x-labz/UV-badge/README.md

# UV-badge

Project site on hackaday.io https://hackaday.io/project/4706-uv-badge 

Twitter: @xLabzNet
