x-labz/UV-badge/design/prog-adapter/prog-adapter.FCStd

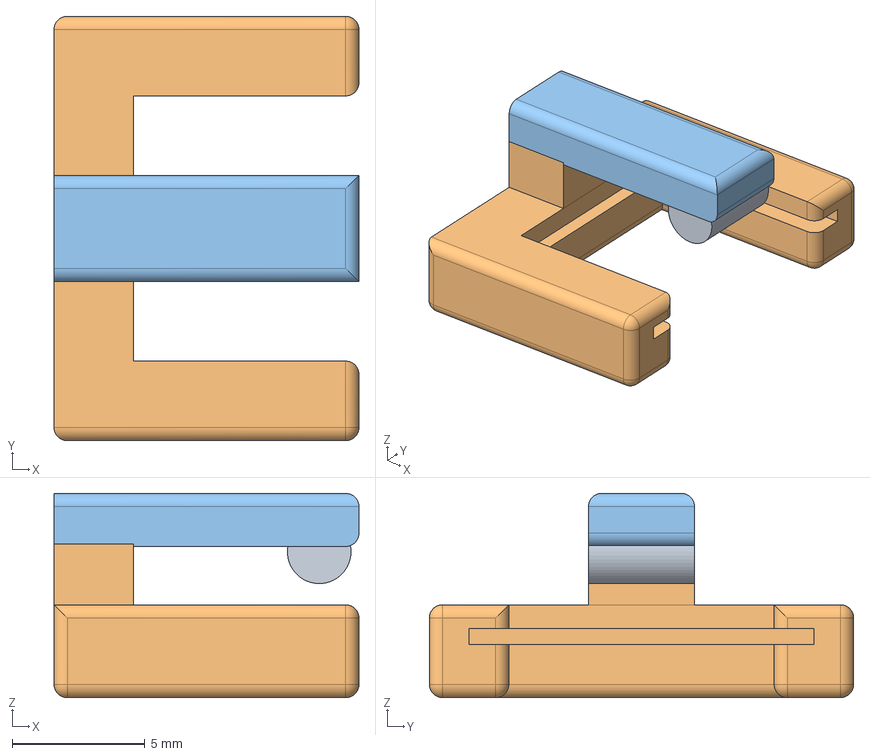
[picture p7: CAD file, 2015-08-31]
design/prog-adapter/prog-adapter.FCStd
11.5 x 16.0 x 7.70 mm
