x-labz/UV-badge/design/UV-case-2.1.4-exp.FCStd

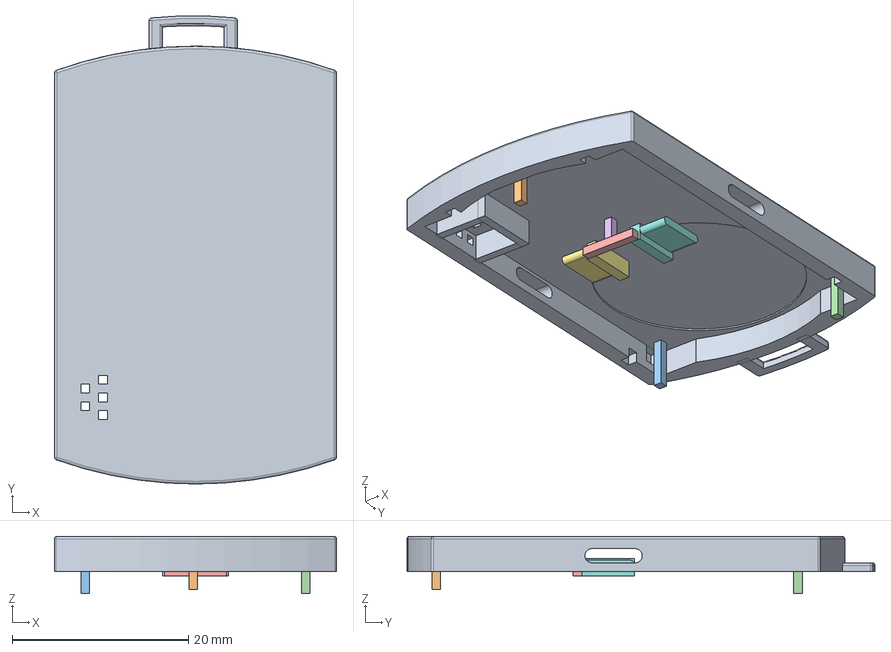
[picture p8: CAD file, 2015-07-29]
design/UV-case-2.1.4-exp.FCStd
32.0 x 53.1 x 6.50 mm
Fusion-btn-1
Fusion-btn-2
