x-labz/UV-badge/(list of files, cad)

Other CAD files:
design/UV-case-2.1.4-exp.stl
design/prog-adapter/prog-adapter.stl
