x-labz/UV-badge/(threads)

Thread 1 (2016-06-06):

BOM

loldavid6, 2016-06-06:
The BOM reports that it is formatted wrong, just letting you know.
