x-labz/UV-badge/hardware/uvi-2.1.brd

## EAGLE design hardware/uvi-2.1.brd (2015-07-29)

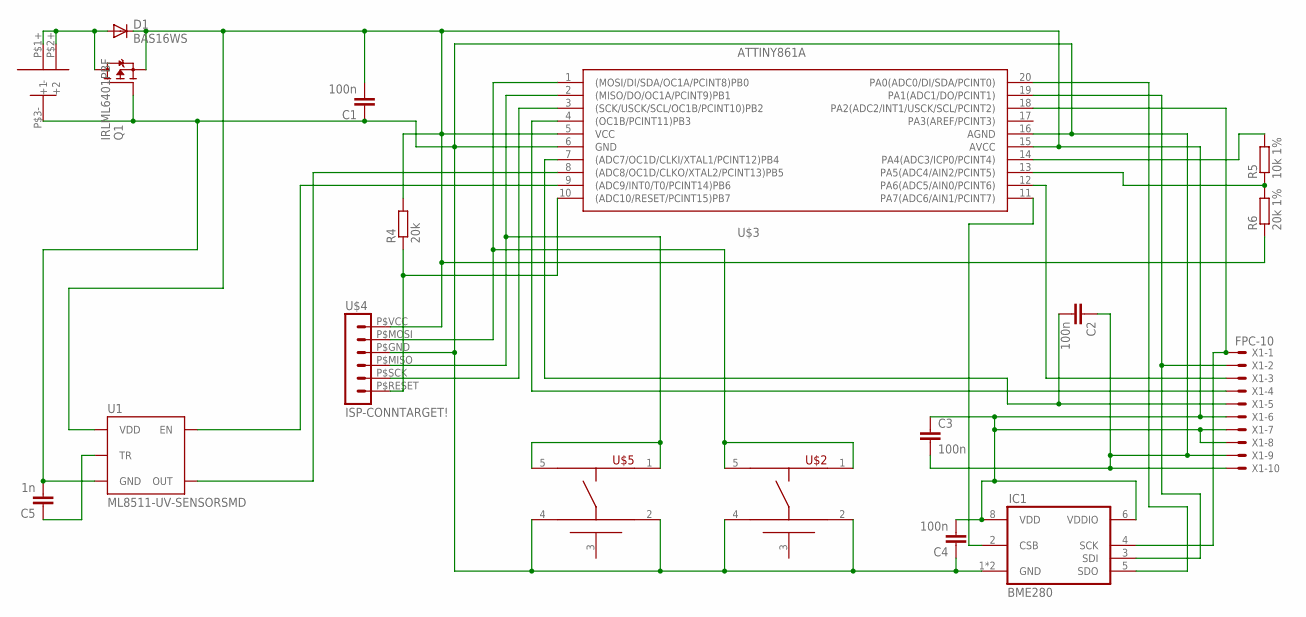
[picture p9: schematic uvi-2.1.sch]

Parts:
C1, C2, C3, C4: 100n; C0805
C5: 1n; C0805
D1: BAS16WS; SOD323-W
IC1: BME280; BMP280
Q1: IRLML6401PBF; SOT23
R4: 20k; R0805
R5: 10k 1%; R0805
R6: 20k 1%; R0805
U1: ML8511-UV-SENSORSMD; ML8511
U$1: CR2016; BAT-HLD-002
U$2, U$5: KMSXXXG; C&K-KMS-SWITCH
U$3: ATTINY861A; TSSOP20
U$4: ISP-CONNTARGET!; ISP-TARGET
X1: FPC-10; FPC-10-BTM

Connections:
GND: C1.1, C2.1, C3.2, C4.1, C5.2, IC1.1 (GND), IC1.7 (GND), Q1.1 (G), U1.5 (GND), U$1.P$3- (-), U$2.2, U$2.4, U$3.6 (GND), U$3.16 (AGND), U$4.P$GND (GND), U$5.2, U$5.4, X1.P$9, X1.P$10
unnamed: D1.A, Q1.3 (D), U$1.P$1+ (+1), U$1.P$2+ (+2)
unnamed: R4.1, U$3.10 ((ADC10/RESET/PCINT15)PB7), U$4.P$RESET (RESET)
unnamed: IC1.5 (SDO), U$3.20 (PA0(ADC0/DI/SDA/PCINT0))
unnamed: R5.2, U$3.14 (PA4(ADC3/ICP0/PCINT4))
unnamed: IC1.4 (SCK), U$3.18 (PA2(ADC2/INT1/USCK/SCL/PCINT2)), X1.P$1
unnamed: C5.1, U1.10 (TR)
unnamed: IC1.3 (SDI), U$3.19 (PA1(ADC1/DO/PCINT1)), X1.P$2
unnamed: U1.8 (OUT), U$3.8 ((ADC8/OC1D/CLKO/XTAL2/PCINT13)PB5)
unnamed: C2.2, U$3.7 ((ADC7/OC1D/CLKI/XTAL1/PCINT12)PB4), X1.P$5
unnamed: U$3.2 ((MISO/DO/OC1A/PCINT9)PB1), U$4.P$MISO (MISO), U$5.1, U$5.5
unnamed: U$3.3 ((SCK/USCK/SCL/OC1B/PCINT10)PB2), U$4.P$SCK (SCK)
unnamed: IC1.2 (CSB), U$3.11 (PA7(ADC6/AIN1/PCINT7))
unnamed: U$3.4 ((OC1B/PCINT11)PB3), X1.P$4
unnamed: U$3.12 (PA6(ADC5/AIN0/PCINT6)), X1.P$3
unnamed: U$2.1, U$2.5, U$3.1 ((MOSI/DI/SDA/OC1A/PCINT8)PB0), U$4.P$MOSI (MOSI)
unnamed: U1.4 (EN), U$3.9 ((ADC9/INT0/T0/PCINT14)PB6)
unnamed: R5.1, R6.2, U$3.13 (PA5(ADC4/AIN2/PCINT5))
VCC: C1.2, C3.1, C4.2, D1.C, IC1.6 (VDDIO), IC1.8 (VDD), Q1.2 (S), R4.2, R6.1, U1.7 (VDD), U$3.5 (VCC), U$3.15 (AVCC), U$4.P$VCC (VCC), X1.P$6, X1.P$7, X1.P$8

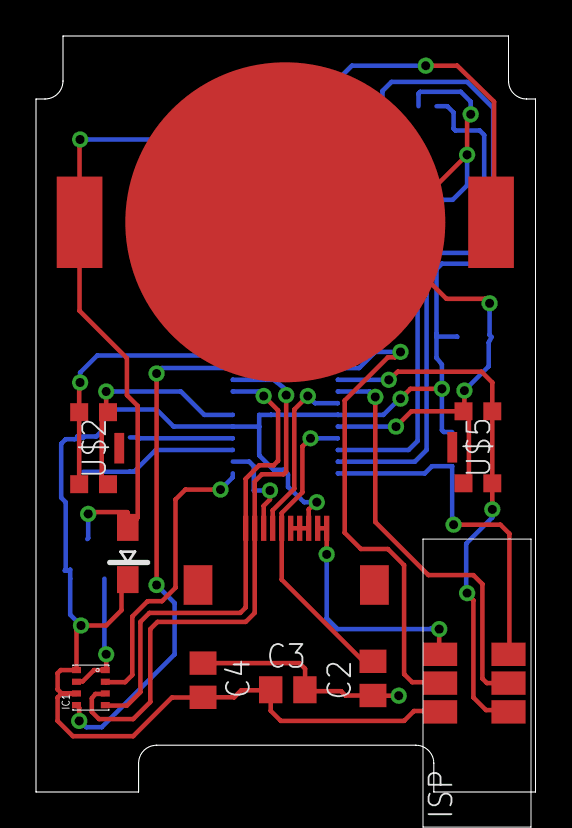
[picture p10: board uvi-2.1.brd from above]

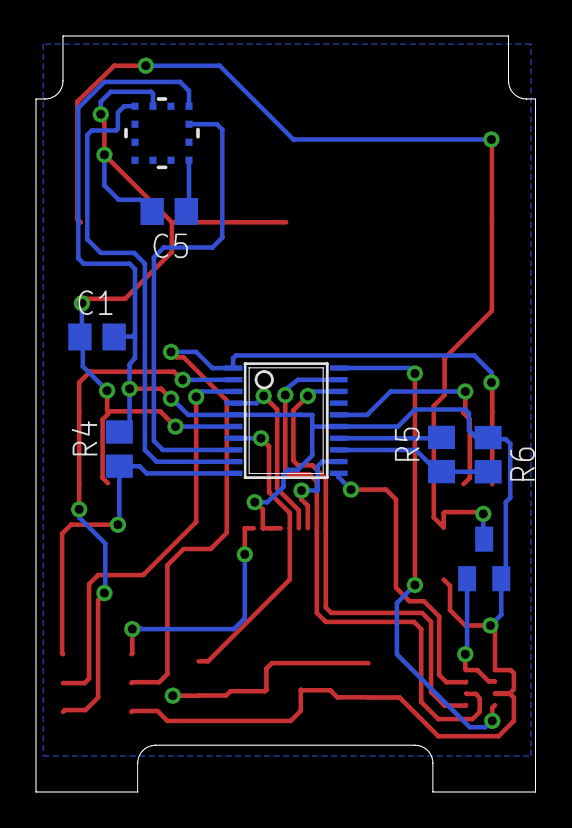
[picture p11: board uvi-2.1.brd from below]

Board: 2 copper layers, 27.8 x 42.0 mm, 18 parts (8 on the bottom side), 19 nets.
