x-labz/UV-badge/firmware/v4.0/set_speed.h

#define SP_8_MHz  1
#define SP_4_MHz  2
#define SP_2_MHz  3
#define SP_1_MHz  4
#define SP_500_kHz  5
#define SP_250_kHz  6
#define SP_125_kHz  7

#ifndef SET_SPEED_H_
#define SET_SPEED_H_

void setSpeed(unsigned char) ;


#endif /* SET_SPEED_H_ */
